sorphin/ISA-DoubleROM/DoubleROM-DOC/DoubleROM-DOC.pdf

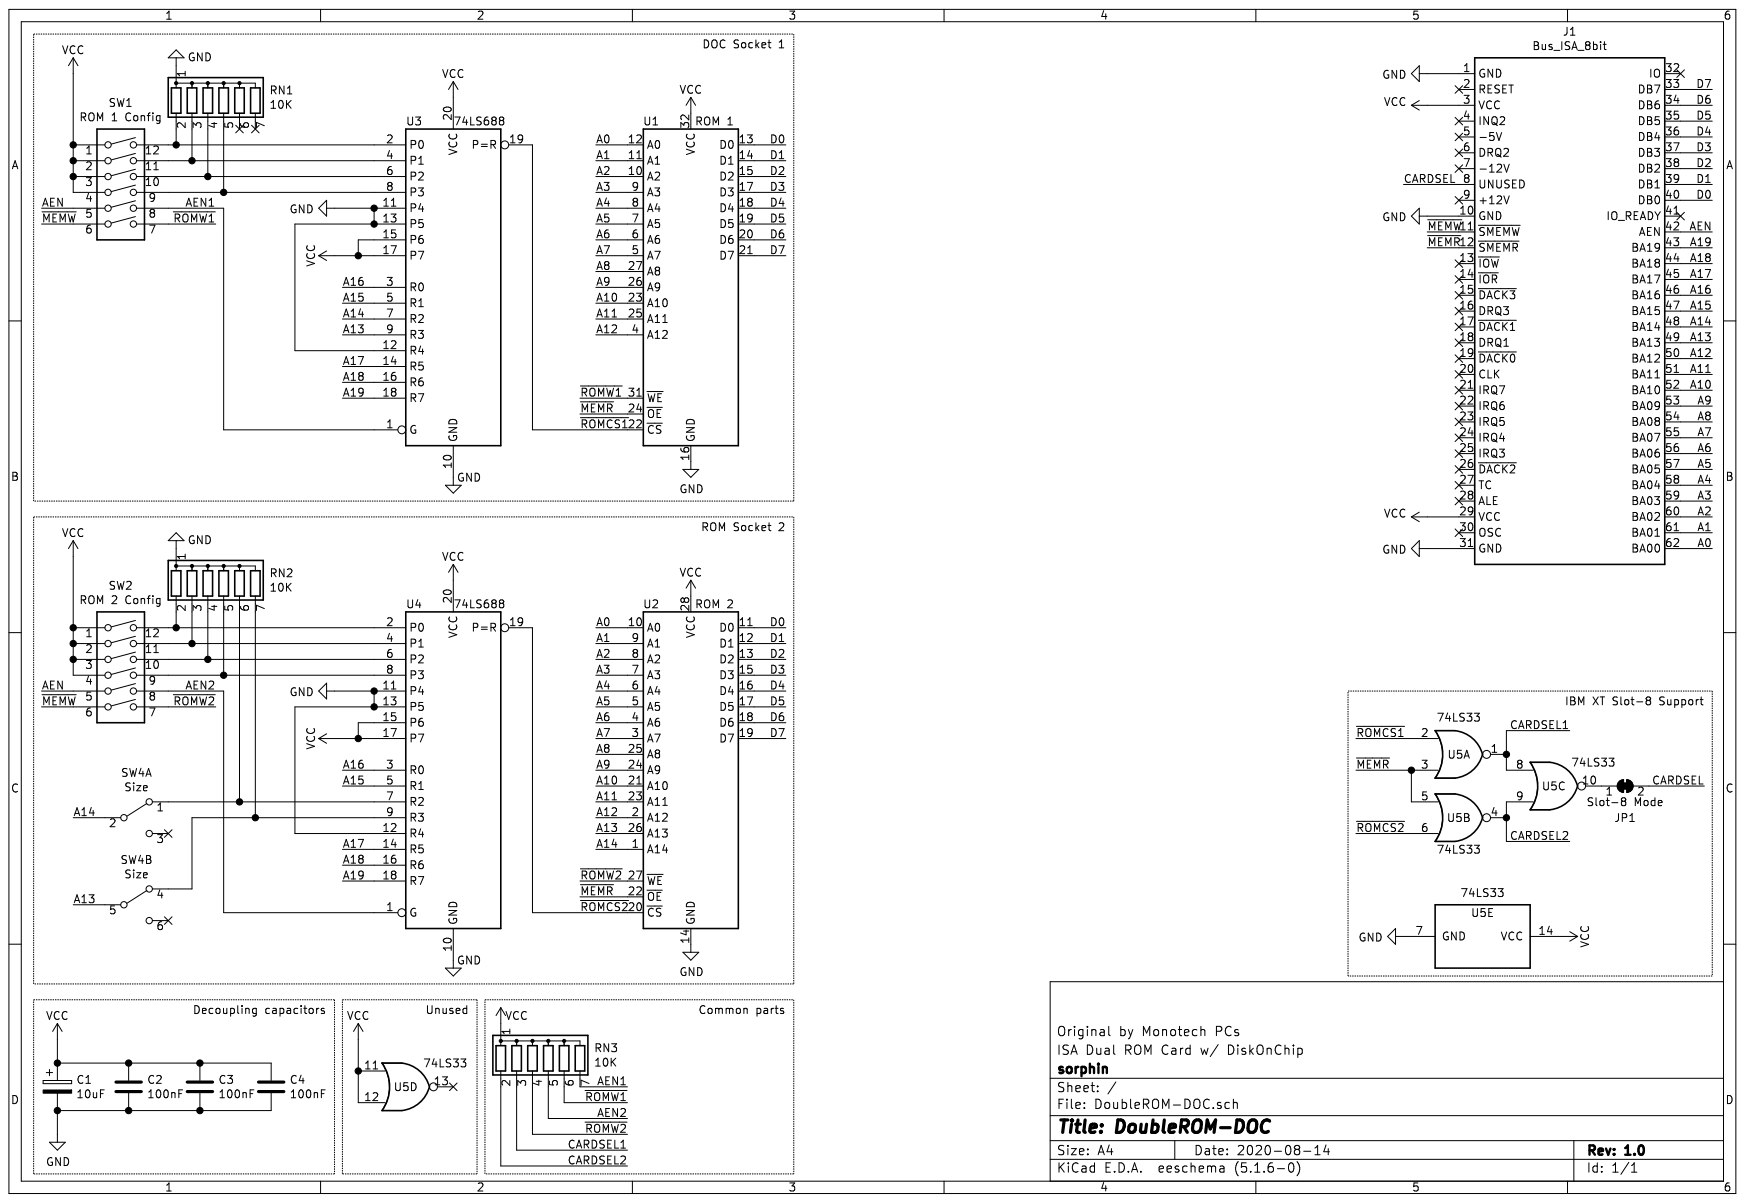
[picture p1: page 1]
