sorphin/ISA-DoubleROM/DoubleROM-DOC/DoubleROM-DOC.kicad_pcb

## KiCad design DoubleROM-DOC/DoubleROM-DOC.kicad_pcb (2023-06-12)

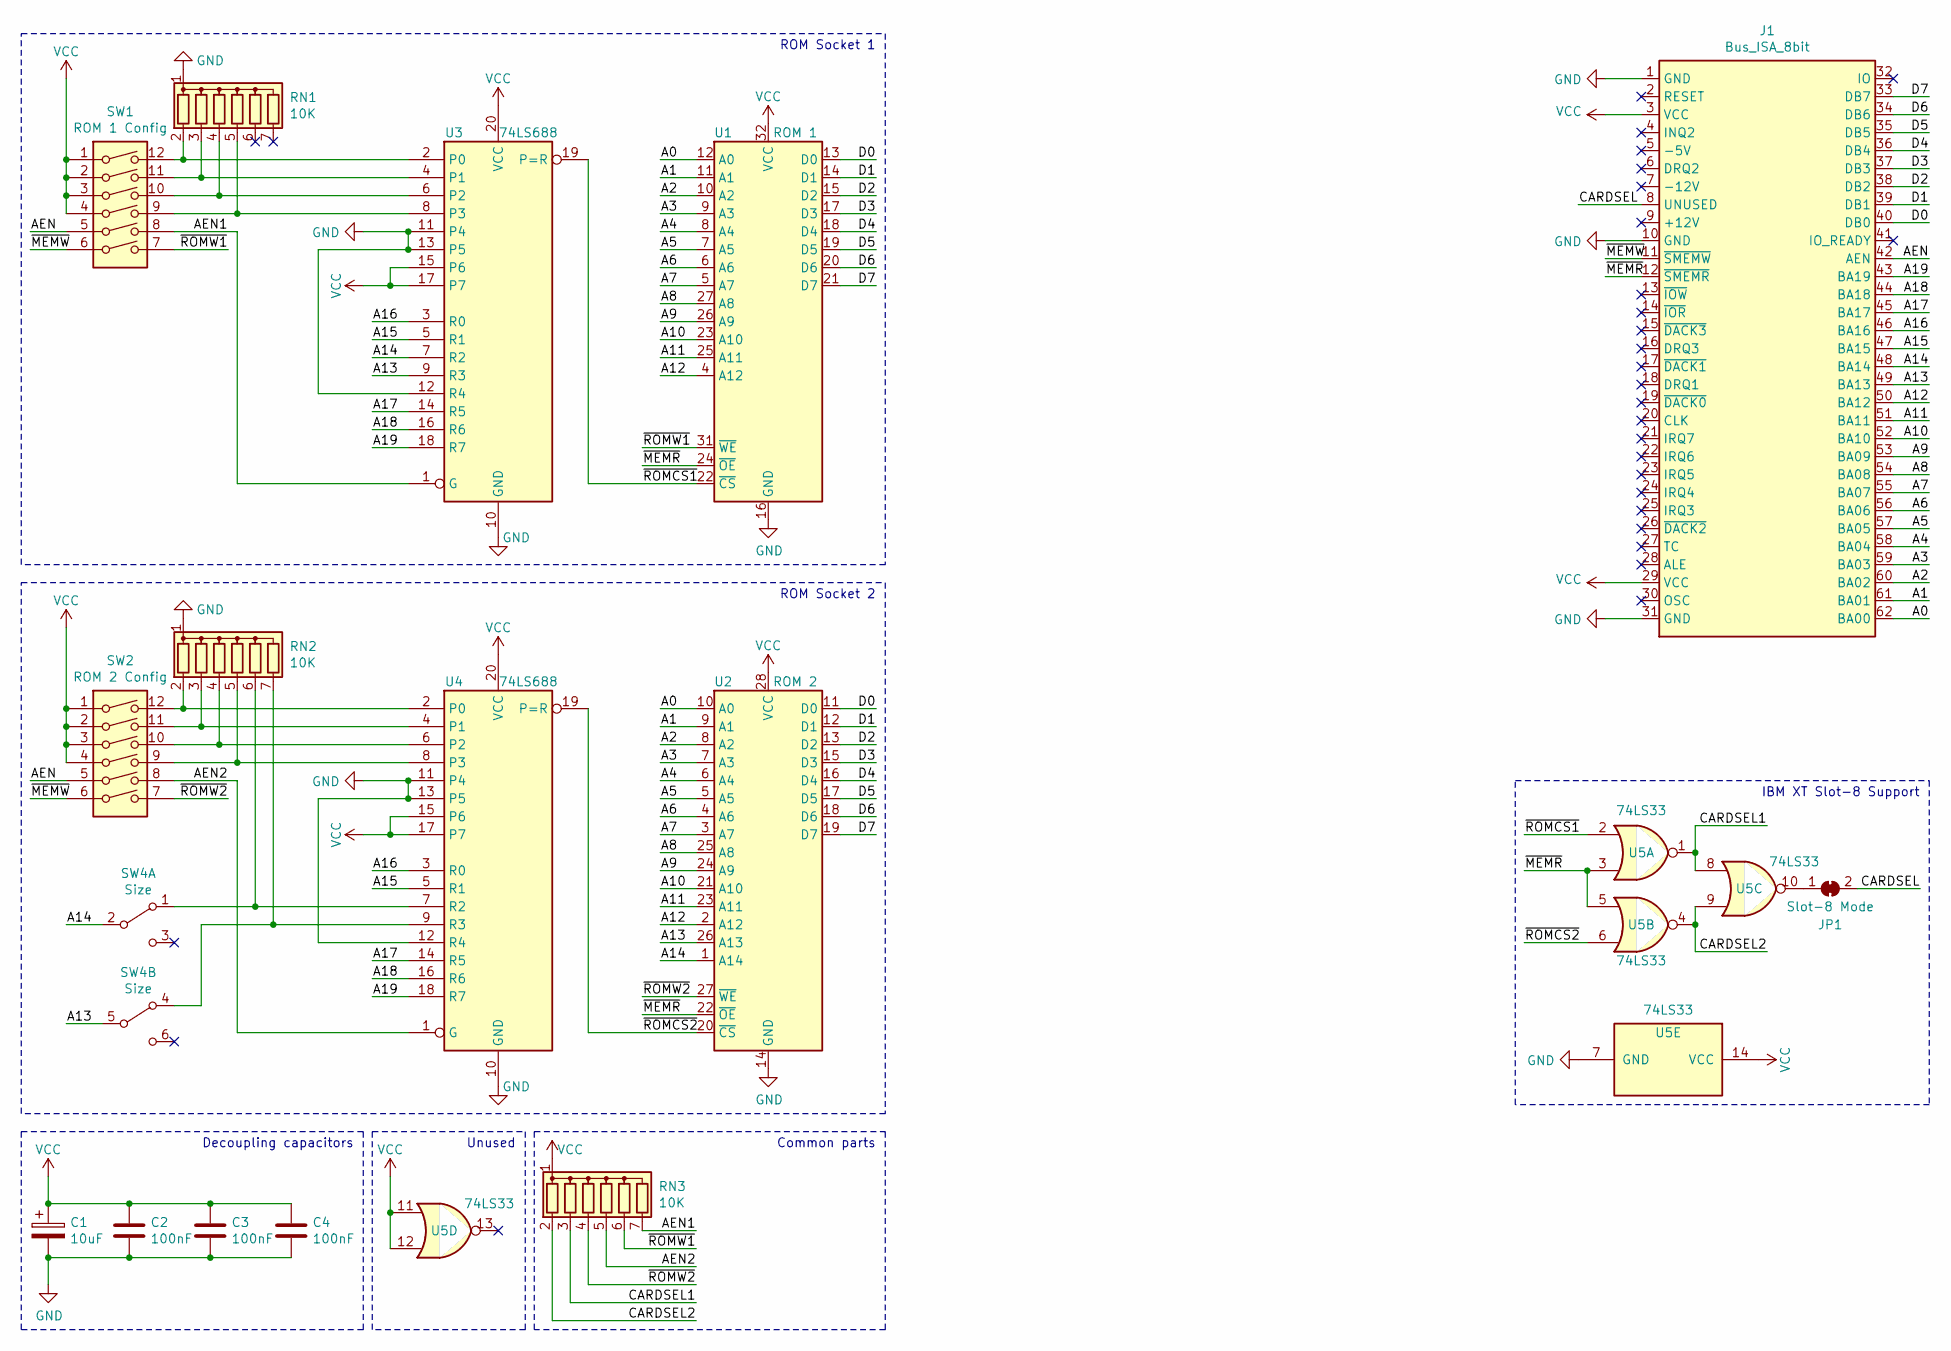
[picture p2: schematic DoubleROM-DOC.sch, DoubleROM]

Parts:
C1: 10uF; CP_Radial_Tantal_D4.5mm_P5.00mm
C2, C3, C4: 100nF; C_Disc_D4.3mm_W1.9mm_P5.00mm
J1: Bus_ISA_8bit; Conn_Bus_ISA8
JP1: Slot-8 Mode; SolderJumper-2_P1.3mm_Bridged_RoundedPad1.0x1.5mm
RN1, RN2, RN3: 10K; R_Array_SIP7
SW1: ROM 1 Config; SW_DIP_SPSTx06_Slide_9.78x17.42mm_W7.62mm_P2.54mm
SW2: ROM 2 Config; SW_DIP_SPSTx06_Slide_9.78x17.42mm_W7.62mm_P2.54mm
SW4: Size; SW_MS-22D18G2
U1: ROM 1; DIP-32_W15.24mm_Socket
U2: ROM 2; DIP-28_W15.24mm_Socket
U3, U4: 74LS688; DIP-20_W7.62mm
U5: 74LS33; SOIC-14_3.9x8.7mm_P1.27mm

Connections:
/A0: J1.62 (BA00), U1.12 (A0), U2.10 (A0)
/A1: J1.61 (BA01), U1.11 (A1), U2.9 (A1)
/A2: J1.60 (BA02), U1.10 (A2), U2.8 (A2)
/A3: J1.59 (BA03), U1.9 (A3), U2.7 (A3)
/A4: J1.58 (BA04), U1.8 (A4), U2.6 (A4)
/A5: J1.57 (BA05), U1.7 (A5), U2.5 (A5)
/A6: J1.56 (BA06), U1.6 (A6), U2.4 (A6)
/A7: J1.55 (BA07), U1.5 (A7), U2.3 (A7)
/A8: J1.54 (BA08), U1.27 (A8), U2.25 (A8)
/A9: J1.53 (BA09), U1.26 (A9), U2.24 (A9)
/A10: J1.52 (BA10), U1.23 (A10), U2.21 (A10)
/A11: J1.51 (BA11), U1.25 (A11), U2.23 (A11)
/A12: J1.50 (BA12), U1.4 (A12), U2.2 (A12)
/A13: J1.49 (BA13), SW4.5 (B), U2.26 (A13), U3.9 (R3)
/A14: J1.48 (BA14), SW4.2 (B), U2.1 (A14), U3.7 (R2)
/A15: J1.47 (BA15), U3.5 (R1), U4.5 (R1)
/A16: J1.46 (BA16), U3.3 (R0), U4.3 (R0)
/A17: J1.45 (BA17), U3.14 (R5), U4.14 (R5)
/A18: J1.44 (BA18), U3.16 (R6), U4.16 (R6)
/A19: J1.43 (BA19), U3.18 (R7), U4.18 (R7)
/AEN: J1.42 (AEN), SW1.5, SW2.5
/AEN1: RN3.7 (R6), SW1.8, U3.1 (G)
/AEN2: RN3.5 (R4), SW2.8, U4.1 (G)
/CARDSEL: J1.8 (UNUSED), JP1.2 (B)
/CARDSEL1: RN3.3 (R2), U5.1, U5.8
/CARDSEL2: RN3.2 (R1), U5.4, U5.9
/D0: J1.40 (DB0), U1.13 (D0), U2.11 (D0)
/D1: J1.39 (DB1), U1.14 (D1), U2.12 (D1)
/D2: J1.38 (DB2), U1.15 (D2), U2.13 (D2)
/D3: J1.37 (DB3), U1.17 (D3), U2.15 (D3)
/D4: J1.36 (DB4), U1.18 (D4), U2.16 (D4)
/D5: J1.35 (DB5), U1.19 (D5), U2.17 (D5)
/D6: J1.34 (DB6), U1.20 (D6), U2.18 (D6)
/D7: J1.33 (DB7), U1.21 (D7), U2.19 (D7)
/~MEMR: J1.12 (~SMEMR), U1.24 (~OE), U2.22 (~OE), U5.3, U5.5
/~MEMW: J1.11 (~SMEMW), SW1.6, SW2.6
/~ROMCS1: U1.22 (~CS), U3.19 (P=R), U5.2
/~ROMCS2: U2.20 (~CS), U4.19 (P=R), U5.6
/~ROMW1: RN3.6 (R5), SW1.7, U1.31 (~WE)
/~ROMW2: RN3.4 (R3), SW2.7, U2.27 (~WE)
GND: C1.2, C2.2, C3.2, C4.2, J1.1 (GND), J1.10 (GND), J1.31 (GND), RN1.1 (common), RN2.1 (common), U1.16 (GND), U2.14 (GND), U3.10 (GND), U3.11 (P4), U3.12 (R4), U3.13 (P5), U4.10 (GND), U4.11 (P4), U4.12 (R4), U4.13 (P5), U5.7 (GND)
unnamed: JP1.1 (A), U5.10
unnamed: RN1.2 (R1), SW1.12, U3.2 (P0)
unnamed: RN1.3 (R2), SW1.11, U3.4 (P1)
unnamed: RN1.4 (R3), SW1.10, U3.6 (P2)
unnamed: RN1.5 (R4), SW1.9, U3.8 (P3)
unnamed: RN2.2 (R1), SW2.12, U4.2 (P0)
unnamed: RN2.3 (R2), SW2.11, U4.4 (P1)
unnamed: RN2.4 (R3), SW2.10, U4.6 (P2)
unnamed: RN2.5 (R4), SW2.9, U4.8 (P3)
unnamed: RN2.6 (R5), SW4.1 (A), U4.7 (R2)
unnamed: RN2.7 (R6), SW4.4 (A), U4.9 (R3)
VCC: C1.1, C2.1, C3.1, C4.1, J1.3 (VCC), J1.29 (VCC), RN3.1 (common), SW1.1, SW1.2, SW1.3, SW1.4, SW2.1, SW2.2, SW2.3, SW2.4, U1.32 (VCC), U2.28 (VCC), U3.15 (P6), U3.17 (P7), U3.20 (VCC), U4.15 (P6), U4.17 (P7), U4.20 (VCC), U5.11, U5.12, U5.14 (VCC)

Notes on the sheet:
Unused
Decoupling capacitors
IBM XT Slot-8 Support
ROM Socket 1
ROM Socket 2
Common parts

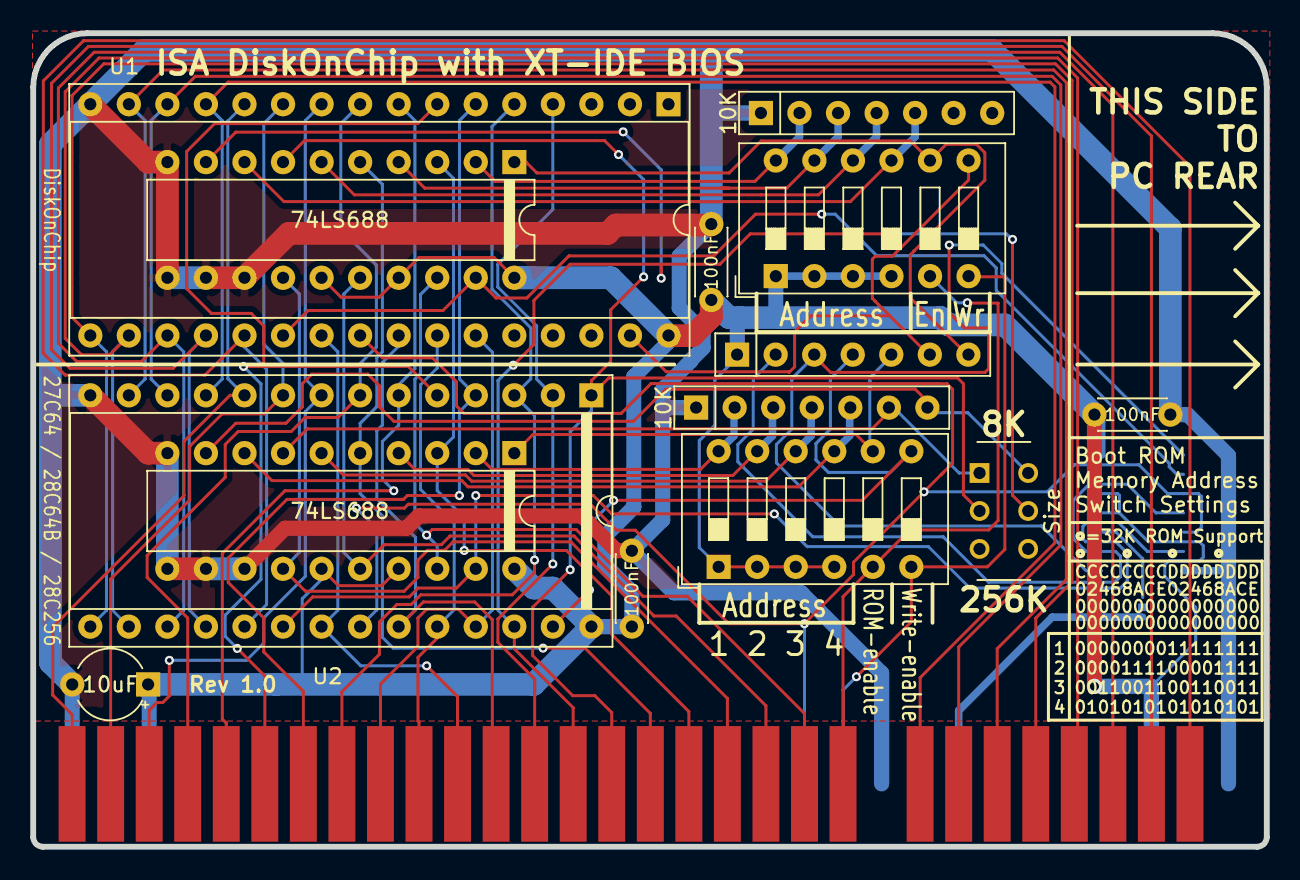
[picture p3: board DoubleROM-DOC.kicad_pcb from above]

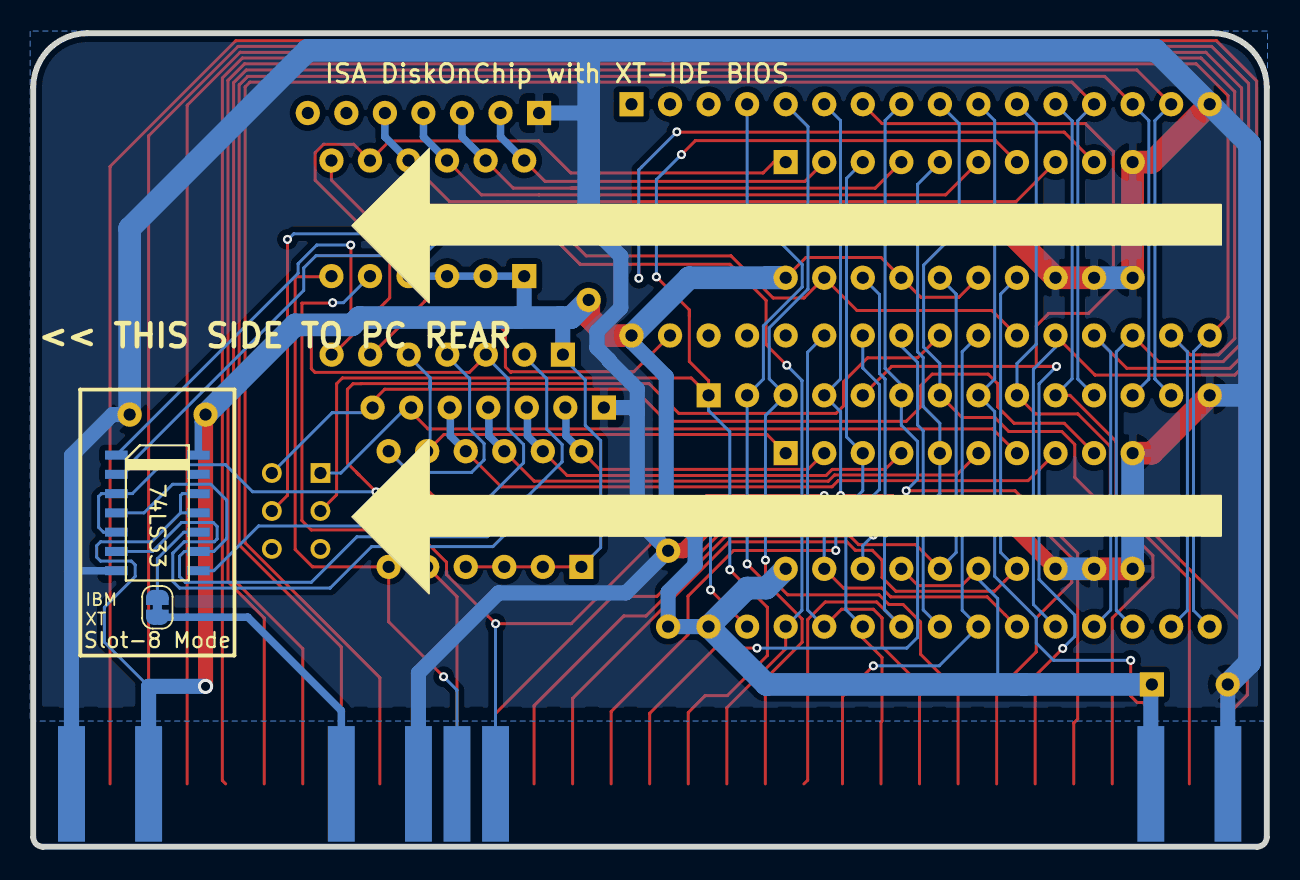
[picture p4: board DoubleROM-DOC.kicad_pcb from below]

Board: 2 copper layers, 81.3 x 53.6 mm, 17 parts (2 on the bottom side), 53 nets.
