sorphin/ISA-DoubleROM/(commit log)

2023-06-12 Add files via upload
    Revised DoubleRom board to have 1 ROM socket and a DiskOnChip Socket. Tested working. May add activity LED in future.
    [DoubleROM-DOC-prefix.kicad_pcb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]
2023-06-12 Corrected schematic info to reflect DOC addition
    [DoubleROM-DOC.sch]
2023-06-21 Sunc up PDF and .sch schematic file.
    [DoubleROM-DOC.sch]
